tarikvillalobos/lockers/fabricacao/lista-de-materiais-A1.csv

Código | Descrição | Conjunto | Material | Espessura (mm) | Qtd | Planificado L (mm) | Planificado A (mm) | Massa unit. (kg) | Massa total (kg) | Dobras | Corte (m) | Arquivo DXF | Acabamento
LR-001 | Base | Base | Aço carbono SAE 1008 laminado a frio | 2 | 1 | 446,92 | 416,92 | 2,897 | 2,897 | 4 | 1,97 | dxf/LR-001.dxf | Pintura eletrostática RAL 7021
LR-002 | Tampo | Tampo | Aço carbono SAE 1008 laminado a frio | 2 | 1 | 446,92 | 416,92 | 2,904 | 2,904 | 4 | 1,82 | dxf/LR-002.dxf | Pintura eletrostática RAL 7021
LR-010-CHV | Lateral direita | Carcaça soldada | Aço carbono SAE 1008 laminado a frio | 2 | 1 | 437,84 | 1012,92 | 6,908 | 6,908 | 6 | 3,04 | dxf/LR-010-CHV.dxf | Pintura eletrostática RAL 7016
LR-011-CHV | Lateral esquerda | Carcaça soldada | Aço carbono SAE 1008 laminado a frio | 2 | 1 | 437,84 | 1012,92 | 6,908 | 6,908 | 6 | 3,04 | dxf/LR-011-CHV.dxf | Pintura eletrostática RAL 7016
LR-020 | Fundo | Carcaça soldada | Aço carbono SAE 1008 laminado a frio | 2 | 1 | 402,92 | 408,92 | 2,572 | 2,572 | 4 | 1,62 | dxf/LR-020.dxf | Pintura eletrostática RAL 7016
LR-021 | Travessa inferior | Carcaça soldada | Aço carbono SAE 1008 laminado a frio | 2 | 1 | 402,92 | 217,92 | 1,366 | 1,366 | 4 | 1,24 | dxf/LR-021.dxf | Pintura eletrostática RAL 7016
LR-022 | Painel superior | Carcaça soldada | Aço carbono SAE 1008 laminado a frio | 2 | 1 | 402,92 | 98,92 | 0,605 | 0,605 | 4 | 1 | dxf/LR-022.dxf | Pintura eletrostática RAL 7016
LR-023 | Rampa do módulo eletrônico | Carcaça soldada | Aço carbono SAE 1008 laminado a frio | 2 | 1 | 426,92 | 357,51 | 2,381 | 2,381 | 2 | 1,7 | dxf/LR-023.dxf | Pintura eletrostática RAL 7016
LR-024 | Batente traseiro da bandeja | Carcaça soldada | Aço carbono SAE 1008 laminado a frio | 2 | 1 | 406 | 28,46 | 0,181 | 0,181 | 1 | 0,87 | dxf/LR-024.dxf | Pintura eletrostática RAL 7016
LR-030-CHV | Porta (frente e trás) | Portas | Aço carbono SAE 1008 laminado a frio | 2 | 2 | 421,84 | 543,84 | 3,529 | 7,058 | 8 | 2,05 | dxf/LR-030-CHV.dxf | Pintura eletrostática RAL 7016
LR-031-CHV | Tampa do módulo eletrônico | Portas | Aço carbono SAE 1008 laminado a frio | 2 | 1 | 421,84 | 153,84 | 0,947 | 0,947 | 8 | 1,24 | dxf/LR-031-CHV.dxf | Pintura eletrostática RAL 7016
LR-040 | Ripa da porta | Portas | Aço carbono SAE 1008 laminado a frio | 1,5 | 16 | 368 | 62,2 | 0,27 | 4,312 | 1 | 0,86 | dxf/LR-040.dxf | Pintura eletrostática RAL 7016
LR-041 | Ripa da travessa | Carcaça soldada | Aço carbono SAE 1008 laminado a frio | 1,5 | 3 | 374 | 65,28 | 0,287 | 0,862 | 1 | 0,88 | dxf/LR-041.dxf | Pintura eletrostática RAL 7016
LR-050 | Porta do basculante | Basculante | Aço carbono SAE 1008 laminado a frio | 2 | 1 | 392,92 | 249,38 | 1,523 | 1,523 | 5 | 1,28 | dxf/LR-050.dxf | Pintura eletrostática RAL 7016
LR-042 | Ripa do basculante | Basculante | Aço carbono SAE 1008 laminado a frio | 1,5 | 3 | 372 | 53,61 | 0,235 | 0,705 | 1 | 0,85 | dxf/LR-042.dxf | Pintura eletrostática RAL 7016
LR-060 | Piso da bandeja | Mecanismo | Aço galvanizado Z275 | 2 | 1 | 378,92 | 333 | 1,981 | 1,981 | 2 | 1,42 | dxf/LR-060.dxf | Galvanizado (sem pintura)
LR-061 | Placa lateral da bandeja | Mecanismo | Aço galvanizado Z275 | 2 | 2 | 333 | 187 | 0,897 | 1,793 | 0 | 1,03 | dxf/LR-061.dxf | Galvanizado (sem pintura)
LR-062 | Aba superior (viseira) | Mecanismo | Aço galvanizado Z275 | 2 | 1 | 352,92 | 190 | 1,052 | 1,052 | 2 | 1,12 | dxf/LR-062.dxf | Galvanizado (sem pintura)
LR-063 | Biela da porta | Mecanismo | Aço galvanizado Z275 | 3 | 2 | 16 | 197,5 | 0,073 | 0,145 | 0 | 0,47 | dxf/LR-063.dxf | Galvanizado (sem pintura)
LR-064 | Biela da aba | Mecanismo | Aço galvanizado Z275 | 3 | 2 | 16 | 71,61 | 0,025 | 0,05 | 0 | 0,22 | dxf/LR-064.dxf | Galvanizado (sem pintura)
Itens comprados | Qtd
Fechadura de tambor Ø19 com came e 2 chaves | 3
Dobradiça de pino para porta (aço zincado) | 6
Eixo da dobradiça do basculante, aço Ø9 × 372 mm | 1
Pino de biela Ø7 × 10 mm (soldar) | 8
Parafuso M6 × 30 com bucha quadrada (eixo da bandeja) | 2
Rebite rosca M6 (abas das laterais) | 8
Parafuso M6 × 12 cabeça abaulada (base e tampo) | 8
Batente de borracha Ø12 | 3
Perfil de vedação de borracha 8 × 3 mm | 0,4 m
Chumbador M10 para piso | 4
Totais | 43 peças de chapa | 47,1 kg | 47,9 m de corte | 90 dobras
