tarikvillalobos/lockers/fabricacao/aninhamento/chapa-3mm-gi30-1.dxf

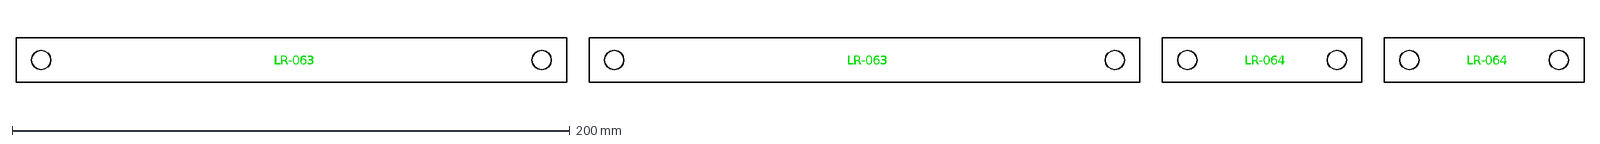
[picture p1: CAD file, 2026-11-10]
fabricacao/aninhamento/chapa-3mm-gi30-1.dxf
LR-063
LR-064
