tarikvillalobos/lockers/fabricacao/dxf/LR-020.dxf

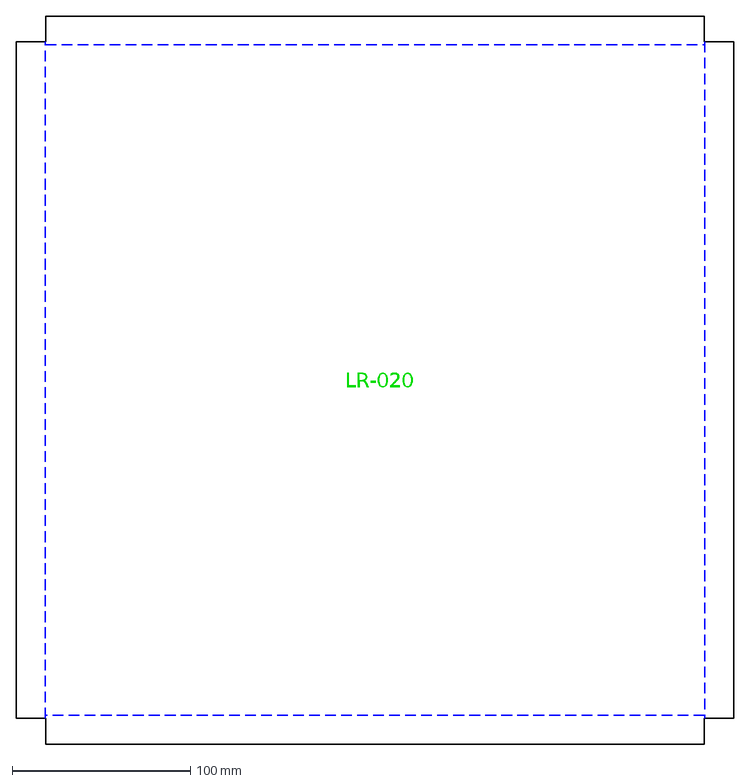
[picture p2: CAD file, 2026-11-10]
fabricacao/dxf/LR-020.dxf
LR-020
