tarikvillalobos/lockers/fabricacao/aninhamento/chapa-2mm-gi20-1.dxf

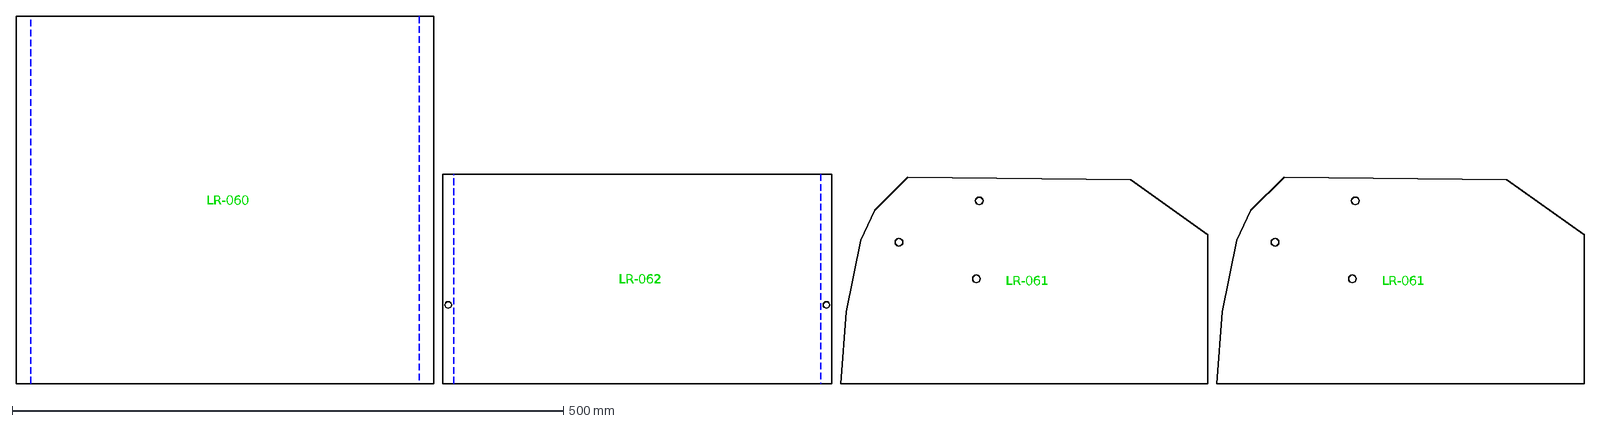
[picture p3: CAD file, 2026-11-10]
fabricacao/aninhamento/chapa-2mm-gi20-1.dxf
LR-060
LR-062
LR-061
