tarikvillalobos/lockers/fabricacao/dxf/LR-022.dxf

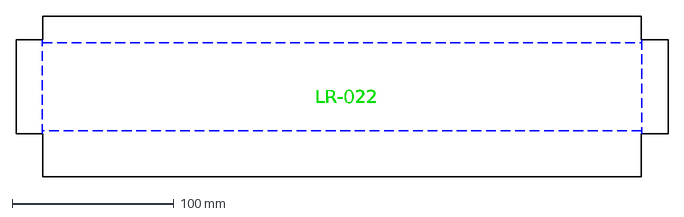
[picture p4: CAD file, 2026-11-10]
fabricacao/dxf/LR-022.dxf
LR-022
