tarikvillalobos/lockers/fabricacao/dxf/LR-064.dxf

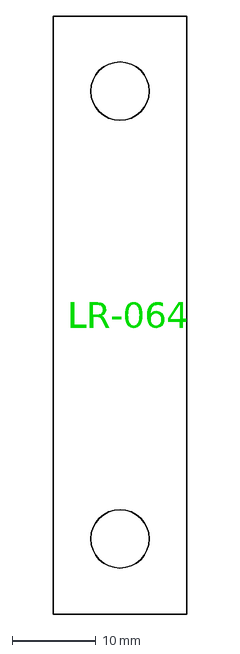
[picture p5: CAD file, 2026-11-10]
fabricacao/dxf/LR-064.dxf
LR-064
