tarikvillalobos/lockers/fabricacao/dxf/LR-040.dxf

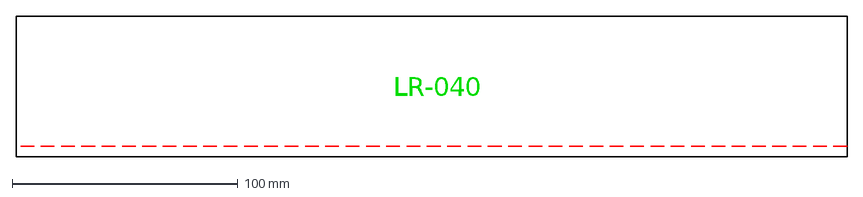
[picture p6: CAD file, 2026-11-10]
fabricacao/dxf/LR-040.dxf
LR-040
