tarikvillalobos/lockers/fabricacao/dxf/LR-002.dxf

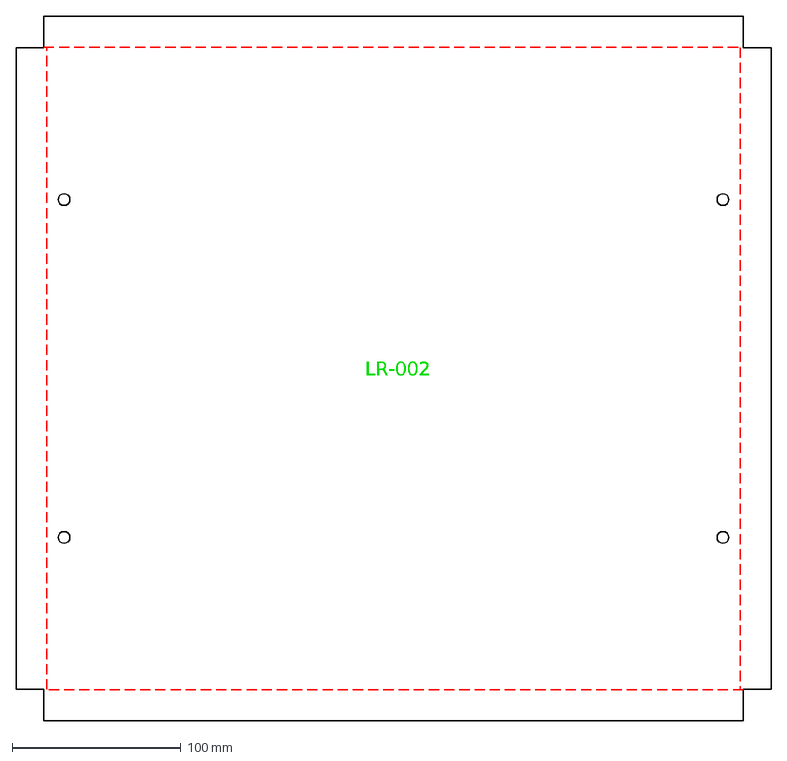
[picture p7: CAD file, 2026-11-10]
fabricacao/dxf/LR-002.dxf
LR-002
