tarikvillalobos/lockers/fabricacao/dxf/LR-030-CHV.dxf

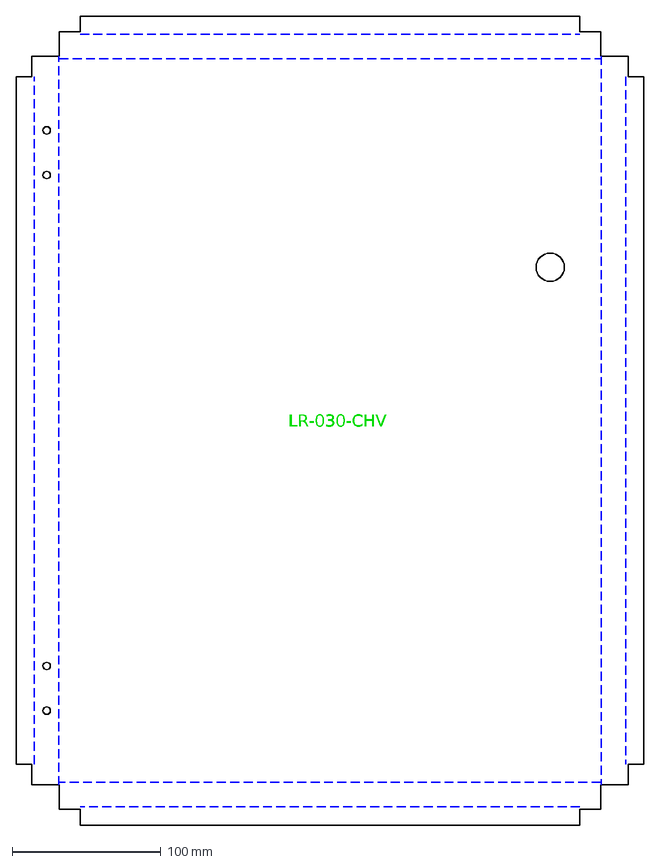
[picture p8: CAD file, 2026-11-10]
fabricacao/dxf/LR-030-CHV.dxf
LR-030-CHV
