tarikvillalobos/lockers/fabricacao/dxf/LR-010-CHV.dxf

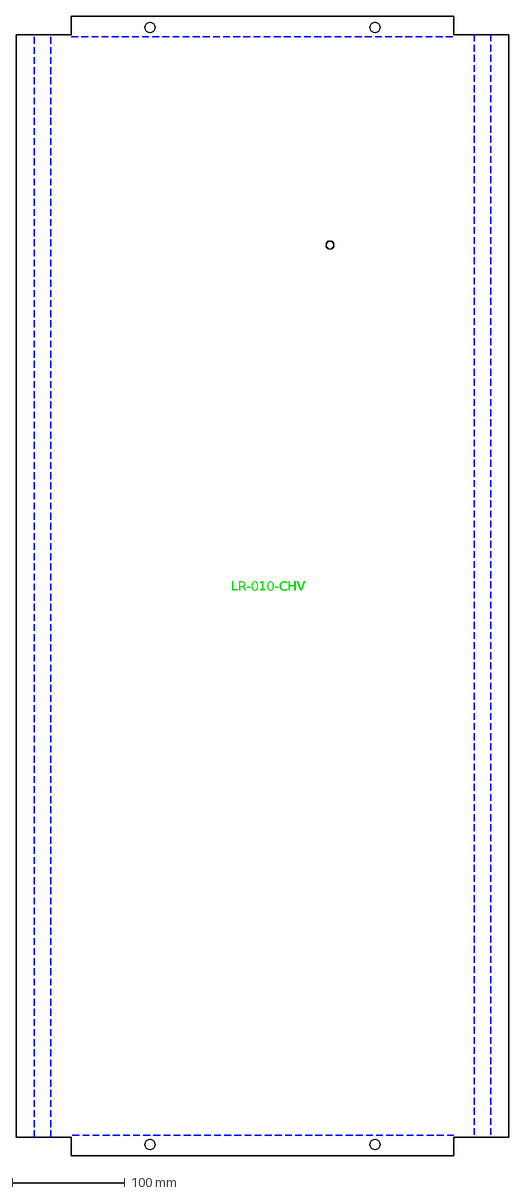
[picture p9: CAD file, 2026-11-10]
fabricacao/dxf/LR-010-CHV.dxf
LR-010-CHV
