tarikvillalobos/lockers/fabricacao/dxf/LR-001.dxf

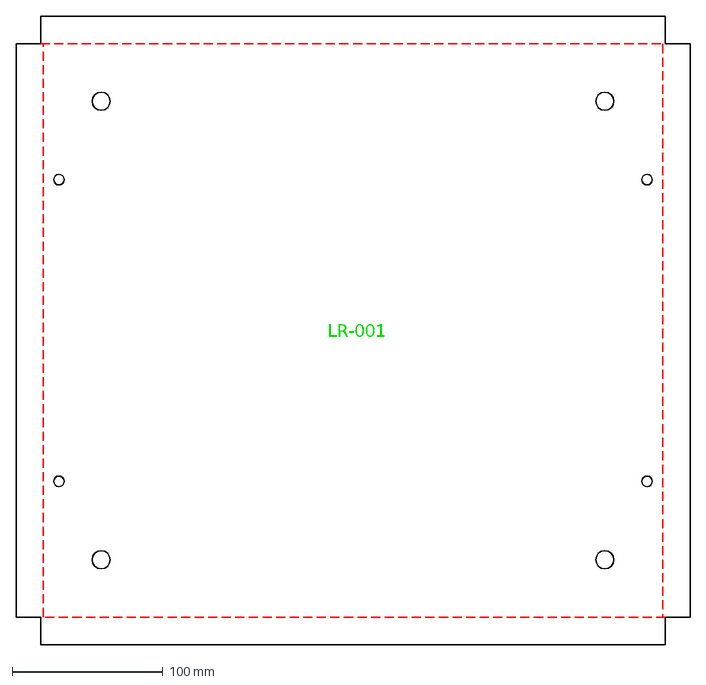
[picture p10: CAD file, 2026-11-10]
fabricacao/dxf/LR-001.dxf
LR-001
