tarikvillalobos/lockers/fabricacao/dxf/LR-021.dxf

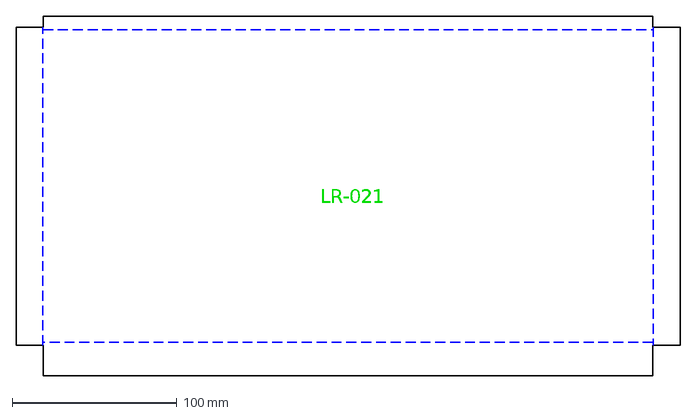
[picture p11: CAD file, 2026-11-10]
fabricacao/dxf/LR-021.dxf
LR-021
