tarikvillalobos/lockers/fabricacao/dxf/LR-041.dxf

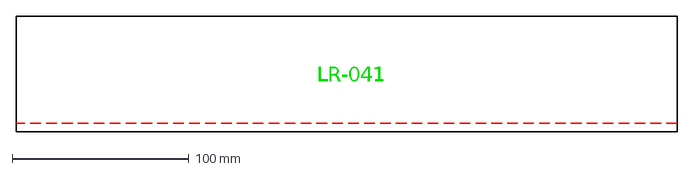
[picture p12: CAD file, 2026-11-10]
fabricacao/dxf/LR-041.dxf
LR-041
