tarikvillalobos/lockers/fabricacao/dxf/LR-024.dxf

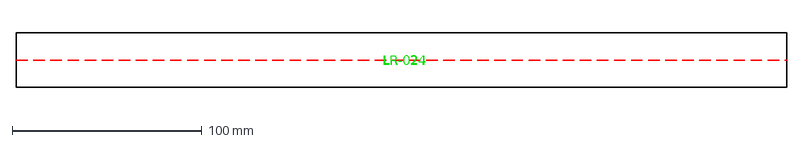
[picture p13: CAD file, 2026-11-10]
fabricacao/dxf/LR-024.dxf
LR-024
