tarikvillalobos/lockers/fabricacao/dxf/LR-061.dxf

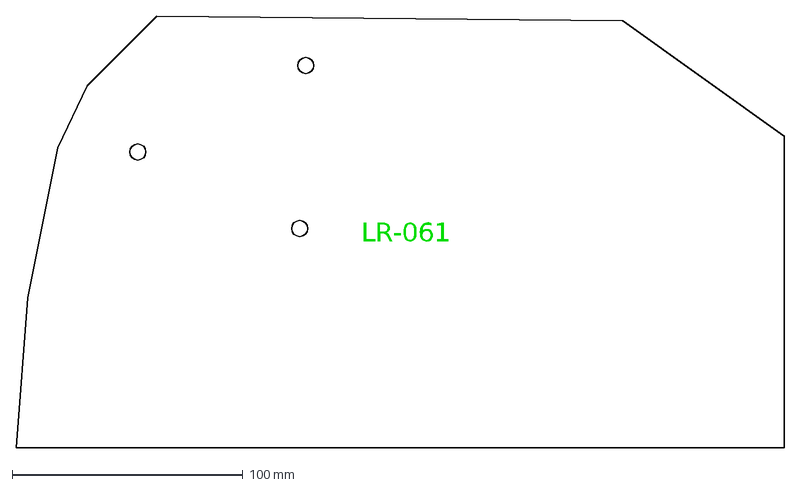
[picture p14: CAD file, 2026-11-10]
fabricacao/dxf/LR-061.dxf
LR-061
