tarikvillalobos/lockers/fabricacao/dxf/LR-063.dxf

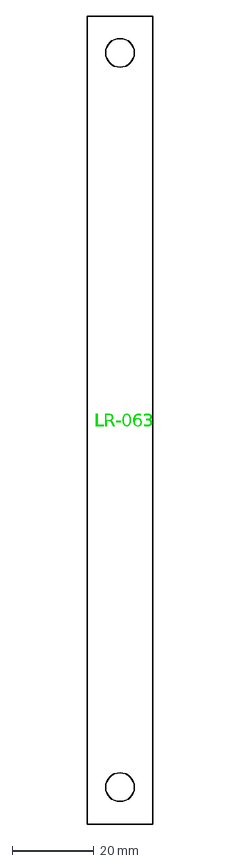
[picture p15: CAD file, 2026-11-10]
fabricacao/dxf/LR-063.dxf
LR-063
