tarikvillalobos/lockers/fabricacao/dxf/LR-011-CHV.dxf

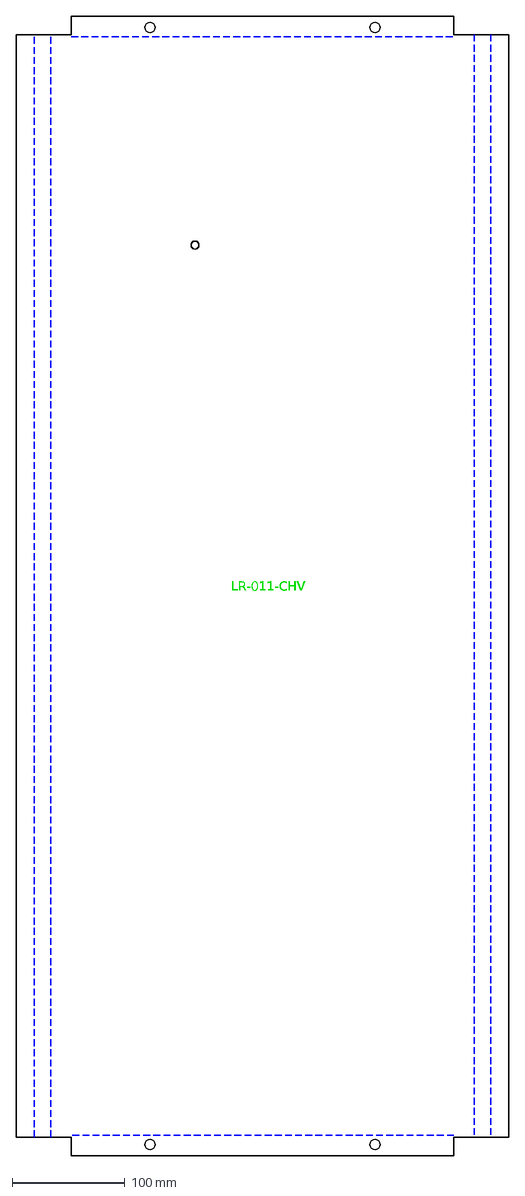
[picture p16: CAD file, 2026-11-10]
fabricacao/dxf/LR-011-CHV.dxf
LR-011-CHV
