tarikvillalobos/lockers/fabricacao/dxf/LR-042.dxf

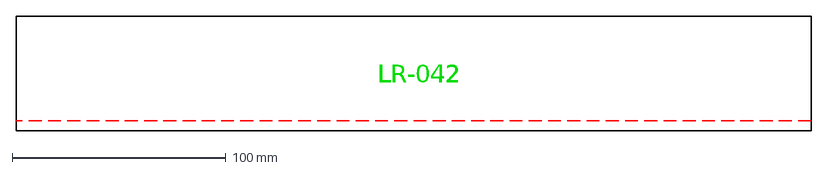
[picture p17: CAD file, 2026-11-10]
fabricacao/dxf/LR-042.dxf
LR-042
