tarikvillalobos/lockers/fabricacao/dxf/LR-060.dxf

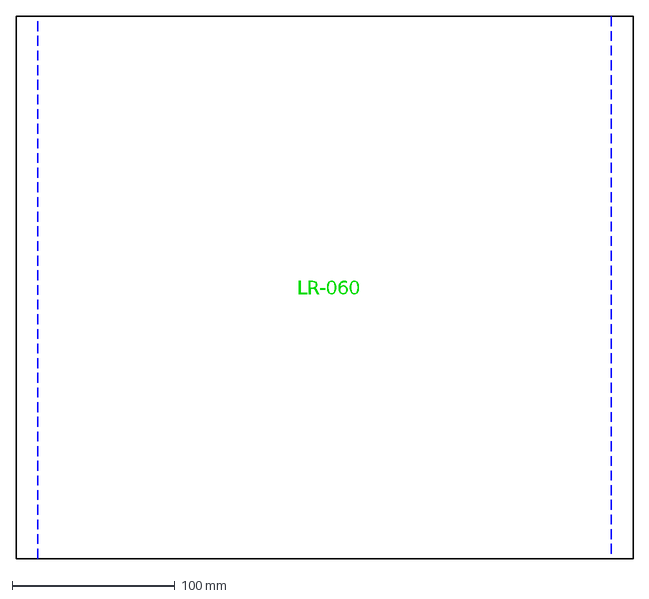
[picture p18: CAD file, 2026-11-10]
fabricacao/dxf/LR-060.dxf
LR-060
