tarikvillalobos/lockers/fabricacao/dxf/LR-031-CHV.dxf

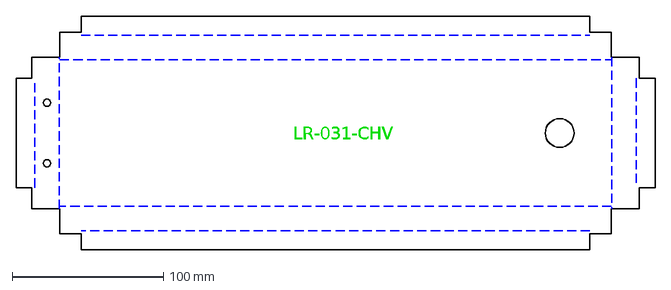
[picture p19: CAD file, 2026-11-10]
fabricacao/dxf/LR-031-CHV.dxf
LR-031-CHV
