tarikvillalobos/lockers/fabricacao/dxf/LR-030-SOL.dxf

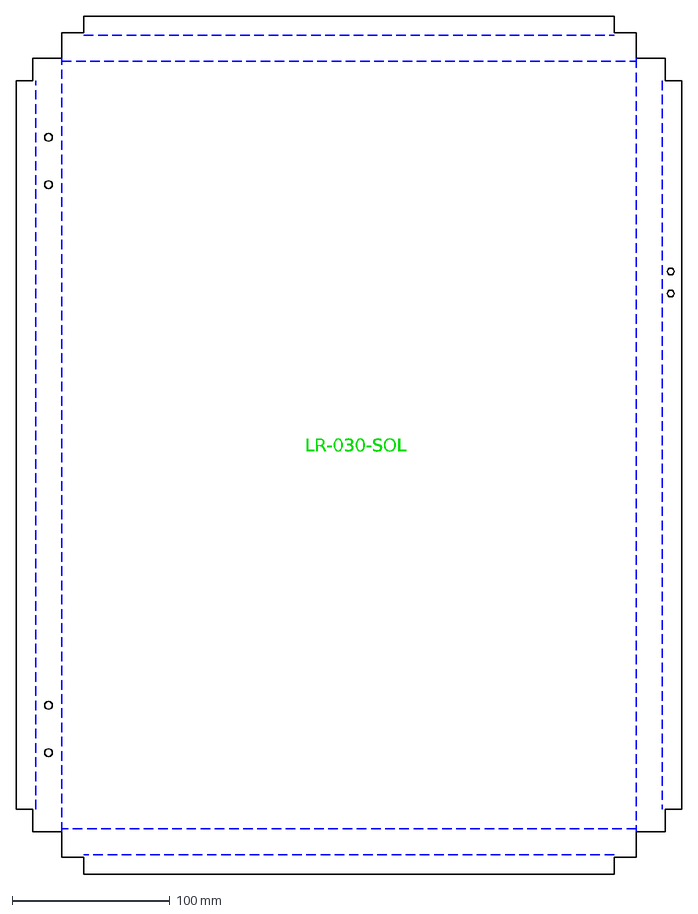
[picture p20: CAD file, 2026-11-10]
fabricacao/dxf/LR-030-SOL.dxf
LR-030-SOL
