tarikvillalobos/lockers/fabricacao/dxf/LR-010-SOL.dxf

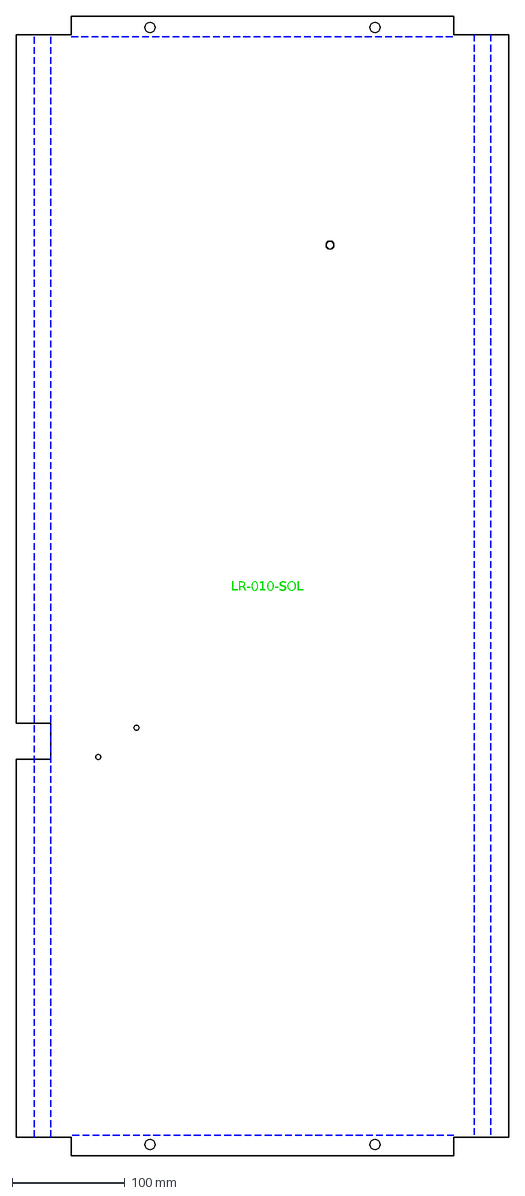
[picture p21: CAD file, 2026-11-10]
fabricacao/dxf/LR-010-SOL.dxf
LR-010-SOL
