tarikvillalobos/lockers/fabricacao/dxf/LR-023.dxf

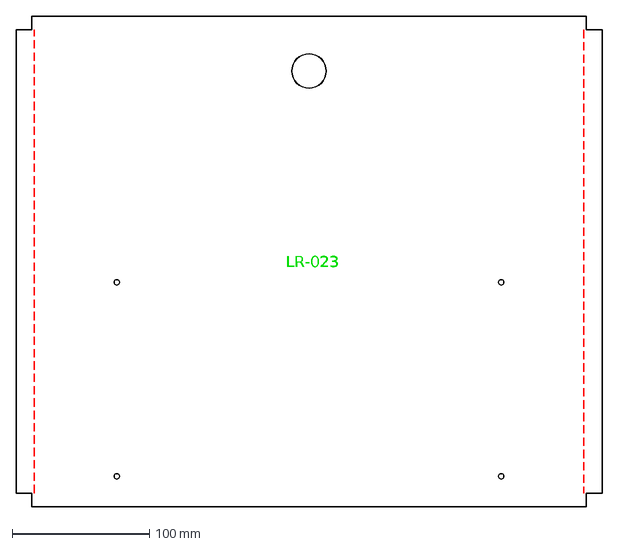
[picture p22: CAD file, 2026-11-10]
fabricacao/dxf/LR-023.dxf
LR-023
