tarikvillalobos/lockers/fabricacao/dxf/LR-011-SOL.dxf

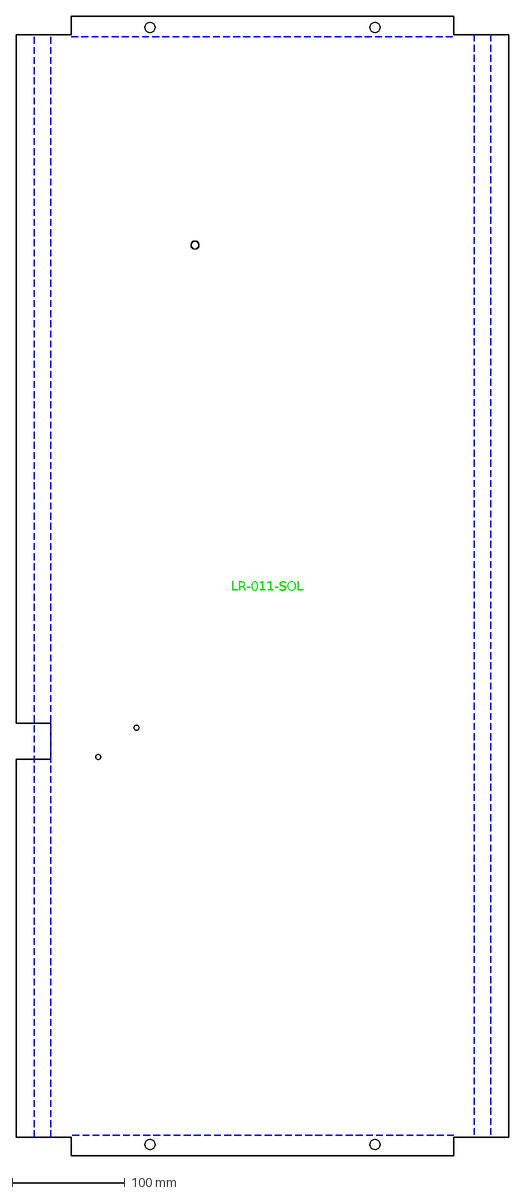
[picture p23: CAD file, 2026-11-10]
fabricacao/dxf/LR-011-SOL.dxf
LR-011-SOL
