tarikvillalobos/lockers/fabricacao/dxf/LR-062.dxf

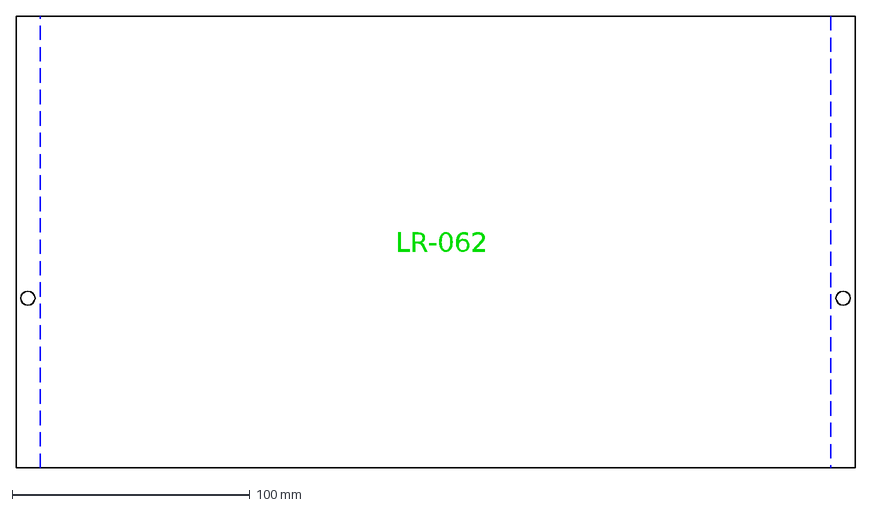
[picture p24: CAD file, 2026-11-10]
fabricacao/dxf/LR-062.dxf
LR-062
