tarikvillalobos/lockers/fabricacao/dxf/LR-050.dxf

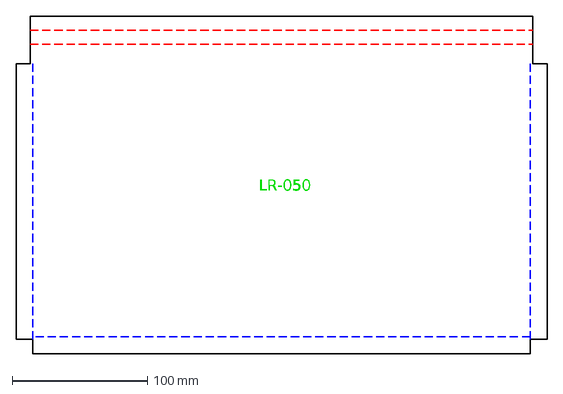
[picture p25: CAD file, 2026-11-10]
fabricacao/dxf/LR-050.dxf
LR-050
