tarikvillalobos/lockers/(list of files, cad)

Other CAD files:
fabricacao/aninhamento/chapa-1,5mm-crs15-1.dxf
fabricacao/aninhamento/chapa-2mm-crs20-1.dxf
