tarikvillalobos/lockers/(commit log)

2026-11-08 feat: add interactive 3D residential parcel locker with three.js
    Functional model of the LR-1020 locker (410 x 380 x 1020 mm) based on the
    SolidWorks drawings: drop flap with anti-theft baffle (four-bar linkage),
    cam lock, lower door, and parcels that fall, stack and can be retrieved.
    Includes x-ray, side cutaway, exploded view, dimensions, CAD edges,
    camera presets and finishes.
2026-11-08 feat: add rear door with independent cam lock
    Mirror the front door on the back panel (same 368 x 490 mm opening):
    rear rail, seal and stile returns as lock keeper, its own key and cam.
    Doors now have independent state; parcels can be retrieved through
    either door. Adds rear door status, controls, U/T shortcuts and a
    rear camera view.
    [Locker.js]
2026-11-09 feat: add anti-theft chute under drop flap and remove baffle fold
    Add a fixed sloped plate below the drop flap, from the front rail down
    to the baffle's lower edge, closing the reach-in gap when the flap is
    open and guiding parcels into the compartment. Remove the bent lip at
    the bottom of the baffle so items can't snag on it. Parcels now slide
    over the chute before dropping.
    [Locker.js]
2026-11-09 feat: make drop flap floor plate rotate with the flap
    Replace the fixed chute and the short inner lip with a longer floor
    plate attached to the drop flap. Closed, it slopes down to near the
    baffle and acts as the parcel ramp; open, it rises as the tray's back
    wall. Parcels slide off its rear edge before dropping.
    [Locker.js]
2026-11-09 feat: bend drop flap floor plate downward
    The floor plate keeps rotating with the drop flap but now has a bend:
    the first 60 mm follow the original lip angle, then it drops at 60 deg.
    Closed, it ramps parcels steeply into the compartment; open, it rises
    much less. Removes the fixed chute and lowers the retrieval exit path
    so parcels don't cross the plate.
    [Locker.js]
2026-11-09 feat: raise anti-theft baffle to close gap with flap floor
    Move the baffle pivot 100 mm up, lengthen the plate to 280 mm and bring
    the link point closer to the pivot (140 mm) so the baffle swings ~49 deg.
    With the flap open, its lower edge now sits ~15 mm from the flap's floor
    plate, closing the reach-in gap; clearance stays >= 15 mm over the full
    0-75 deg travel.
2026-11-09 feat: reduce drop flap face height to 240 mm
    Make the flap face height a single parameter (HOPPER_FACE_H) driving the
    face, side triangle profile, upper rail and max parcel length on the
    tray. The upper rail now grows down to sit just above the shorter flap,
    keeping the front closed.
2026-11-09 feat: raise drop flap by 60 mm
    Move the flap's front-bottom corner from y=572 to y=632 (HOPPER_Y). The
    lower rail grows up to meet it and the upper rail returns to its
    original height; the pin, link and baffle are relative to the flap and
    move with it, keeping the same clearances.
2026-11-09 feat: raise drop flap another 30 mm
    Move the flap's front-bottom corner to y=662; the flap now spans 662-902 mm, leaving an 18 mm upper rail under the header. Mechanism moves with it.
2026-11-09 feat: raise drop flap another 10 mm
    Move the flap's front-bottom corner to y=672; the flap now spans 672-912 mm, leaving an 8 mm upper rail under the header. Mechanism moves with it.
2026-11-09 feat: add anti-theft stop at the drop flap's outer edge
    Add a 40 mm plate folded 90 deg inward at the top of the flap face.
    Closed it sits inside under the upper rail (>= 3 mm clearance over the
    full travel); open it stands up at the tip of the tray, making it
    harder to pull items back out.
    [Locker.js]
2026-11-09 feat: double the drop flap stop plate to 80 mm
    At 90 deg an 80 mm stop would hit the upper rail while opening, so it is
    tilted 10 deg toward the hinge, keeping >= 6 mm clearance over the full
    travel. Max parcel length on the tray is now derived from the stop
    (192 mm) so parcels never intersect it.
    [Locker.js]
2026-11-09 feat: shorten drop flap stop plate to 60 mm
    Reduce the stop to 75% of its previous length (80 -> 60 mm), keeping the 10 deg tilt. Upper rail clearance stays >= 6 mm and max parcel length on the tray goes to 195 mm.
2026-11-09 revert: remove drop flap stop plate
    Remove the anti-theft stop at the flap's outer edge and restore the max parcel length on the tray to faceH - 32 (208 mm).
    [Locker.js]
2026-11-09 feat: seal side gaps in anti-theft mechanism
    With the flap open, the only paths into the compartment were the 21 mm
    side gaps along the baffle and the open sides of the flap's floor plate.
    Widen the baffle to 386 mm (10 mm gap to the walls), move the links
    outboard (x 196-199) so they clear it, and extend the flap's side plates
    down as cheeks covering the floor plate edges. Clearances over the full
    0-75 deg travel: baffle-side plates 9 mm, baffle-floor 15 mm.
    [Locker.js]
2026-11-09 feat: replace baffle linkage with fixed anti-theft hood
    The linked baffle only closed the path at full opening; with the flap
    half open (30-45 deg) there was a 100-140 mm gap straight into the
    compartment. Replace it with a fixed hood concentric to the flap hinge
    (R = 240 mm) plus fixed side guards, and extend the flap's floor plate
    and side cheeks to 232 mm from the hinge. The floor plate edge now slides
    past the hood with a <= 8 mm gap at every angle from 0 to 75 deg, so the
    flap interior is isolated from the compartment whenever it is open.
    Removes the baffle, links and their pins.
    [Locker.js]
2026-11-09 feat: switch to tilting-tray anti-theft mechanism
    Replace the drop flap, hood and side guards with a Milkcan-style
    mechanism: the front door is a flat flap hinged at the bottom that opens
    to 90 deg (becoming a shelf), and a full-depth internal tray sits just
    below the mouth. Door cranks drive telescopic struts that keep the tray
    horizontal from 10 deg of door opening onward, sealing the upper chamber
    from the compartment (1 mm rear gap under a fixed back stop); in the last
    10 deg of closing the tray tilts 35 deg back and the parcel slides off
    into the compartment. While the tray is tilted the mouth is under 34 mm.
    Parcels now enter flat over the door, ride the tray and drop off its
    rear edge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
    [Locker.js]
2026-11-09 feat: restyle locker after Milkcan Hamilton parcel pillar
    Front, top to bottom: letters slot under the cap with an inner swing
    flap, "Cartas" panel, open pull niche with three rubber bumpers, slatted
    "Encomendas" drop-down door and slatted lower front (the front lower door
    now blends into the slats). The rear door is now full height, giving
    access to a new letters shelf (which also roofs the parcel chamber) and
    the compartment; it carries the tray's rear stop. Adds a top inner flap
    that lowers with the tray, retunes the tray to 30 deg, and adds letter
    deposit/retrieval (slot -> niche ceiling chute -> shelf) with status,
    button and "A" shortcut. Seal still holds: tray level from 10 deg of
    doo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
    [Locker.js]
2026-11-09 feat: replace telescopic struts with slotted flat link arms and trapezoid side plates
    [Locker.js]
2026-11-09 feat: rotating tray plates driven by door link arm and flap linkage
2026-11-09 fix: keep rotating tray, arms and flap inside the frame opening and remove interpenetrations
    [Locker.js]
2026-11-09 fix: restore original flap linkage and lengthen flap to 160 mm
2026-11-09 feat: lengthen top flap to 190 mm so its tip reaches close to the tray floor
2026-11-09 fix: remove hinge support blocks that poked through the side columns
    [Locker.js]
2026-11-09 fix: remove inner hinge leaves of the lower doors that crossed the column sheet
    [Locker.js]
2026-11-09 feat: extend tray floor flush to the door and remove the fixed sill plate
    [Locker.js]
2026-11-09 feat: 5 cm electronics module on top with keyed rear hatch, remove letters, raise mechanism
2026-11-09 feat: stepped electronics compartment, 50 mm at the front and 100 mm rear hatch
2026-11-09 feat: slope the electronics compartment floor from 50 mm at the front to 100 mm at the rear
2026-11-09 feat: make the electronics floor one continuous ramp, round tray plate corner and lower flap hinge to clear it
2026-11-09 feat: add second cabinet model with electronic solenoid locks and model selector
2026-11-09 feat: model the smartlocker solenoid lock with side-plate body and door-mounted U-hook tongue
2026-11-09 feat: electronics hatch always uses key lock; solenoid lock without external LED module
2026-11-09 feat: add third cabinet model with solenoid lock on the delivery drawer
2026-11-09 feat: move drawer solenoid to the top-center of the delivery door
2026-11-09 feat: revert smoked window; door is a single bent sheet with inward closing lips
    [Locker.js]
2026-11-10 feat: sheet-metal CAD engine, fabrication package (DXF, drawings, BOM) and parts page
    [LR-001.dxf, LR-002.dxf, LR-010-CHV.dxf, LR-010-SOL.dxf, LR-011-CHV.dxf, LR-011-SOL.dxf, LR-020.dxf, LR-021.dxf]
2026-11-10 feat: raw-material warehouse on the left, finished-goods stock on the right; sheets now flow from stock to the laser
